hotchk155/pck100clone/docs/chklist.txt

CASE KIT, FASCIA PCB, MAIN PCB

CONTROL PCB W/HEADERS

FIXINGS 

POTS x 6, SWITCHES x 4

SOCKETS x 6

KNOBS x 6

RESISTORS x 13 VALUES 

CAPS/SEMIS

PIEZO

WIRE

LEAFLET

LABEL
