hotchk155/pck100clone/docs/resistorkit.odt

PCLONE2 Resistor Kit

330R x 1 ……….. ORANGE-ORANGE-BROWN

470R x 1…………YELLOW-VIOLET-BROWN

1k x 4 ……………BROWN-BLACK-RED

4k7 x 4 ………….YELLOW-VIOLET-RED

10k x 2 ………….BROWN-BLACK-ORANGE

22k x 5 ………….RED-RED-ORANGE

33k x 2 ………….ORANGE-ORANGE-ORANGE

47k x 12 …………YELLOW-VIOLET-ORANGE

56k x 1…………...GREEN-BLUE-ORANGE

100k x 10………..BROWN-BLACK-YELLOW

220k x 1 …………RED-RED-YELLOW

1M x 1……………BROWN-BLACK-GREEN

4M7 x 1 ………….YELLOW-VIOLET-GREEN

http://six4pix.com/pclone2

sixtyfourpixels@gmail.com

PCLONE2 Resistor Kit

330R x 1 ……….. ORANGE-ORANGE-BROWN

470R x 1…………YELLOW-VIOLET-BROWN

1k x 4 ……………BROWN-BLACK-RED

4k7 x 4 ………….YELLOW-VIOLET-RED

10k x 2 ………….BROWN-BLACK-ORANGE

22k x 5 ………….RED-RED-ORANGE

33k x 2 ………….ORANGE-ORANGE-ORANGE

47k x 12 …………YELLOW-VIOLET-ORANGE

56k x 1…………...GREEN-BLUE-ORANGE

100k x 10………..BROWN-BLACK-YELLOW

220k x 1 …………RED-RED-YELLOW

1M x 1……………BROWN-BLACK-GREEN

4M7 x 1 ………….YELLOW-VIOLET-GREEN

http://six4pix.com/pclone2

sixtyfourpixels@gmail.com

PCLONE2 Resistor Kit

330R x 1 ……….. ORANGE-ORANGE-BROWN

470R x 1…………YELLOW-VIOLET-BROWN

1k x 4 ……………BROWN-BLACK-RED

4k7 x 4 ………….YELLOW-VIOLET-RED

10k x 2 ………….BROWN-BLACK-ORANGE

22k x 5 ………….RED-RED-ORANGE

33k x 2 ………….ORANGE-ORANGE-ORANGE

47k x 12 …………YELLOW-VIOLET-ORANGE

56k x 1…………...GREEN-BLUE-ORANGE

100k x 10………..BROWN-BLACK-YELLOW

220k x 1 …………RED-RED-YELLOW

1M x 1……………BROWN-BLACK-GREEN

4M7 x 1 ………….YELLOW-VIOLET-GREEN

http://six4pix.com/pclone2

sixtyfourpixels@gmail.com

PCLONE2 Resistor Kit

330R x 1 ……….. ORANGE-ORANGE-BROWN

470R x 1…………YELLOW-VIOLET-BROWN

1k x 4 ……………BROWN-BLACK-RED

4k7 x 4 ………….YELLOW-VIOLET-RED

10k x 2 ………….BROWN-BLACK-ORANGE

22k x 5 ………….RED-RED-ORANGE

33k x 2 ………….ORANGE-ORANGE-ORANGE

47k x 12 …………YELLOW-VIOLET-ORANGE

56k x 1…………...GREEN-BLUE-ORANGE

100k x 10………..BROWN-BLACK-YELLOW

220k x 1 …………RED-RED-YELLOW

1M x 1……………BROWN-BLACK-GREEN

4M7 x 1 ………….YELLOW-VIOLET-GREEN

http://six4pix.com/pclone2

sixtyfourpixels@gmail.com

PCLONE2 Resistor Kit

330R x 1 ……….. ORANGE-ORANGE-BROWN

470R x 1…………YELLOW-VIOLET-BROWN

1k x 4 ……………BROWN-BLACK-RED

4k7 x 4 ………….YELLOW-VIOLET-RED

10k x 2 ………….BROWN-BLACK-ORANGE

22k x 5 ………….RED-RED-ORANGE

33k x 2 ………….ORANGE-ORANGE-ORANGE

47k x 12 …………YELLOW-VIOLET-ORANGE

56k x 1…………...GREEN-BLUE-ORANGE

100k x 10………..BROWN-BLACK-YELLOW

220k x 1 …………RED-RED-YELLOW

1M x 1……………BROWN-BLACK-GREEN

4M7 x 1 ………….YELLOW-VIOLET-GREEN

http://six4pix.com/pclone2

sixtyfourpixels@gmail.com

PCLONE2 Resistor Kit

330R x 1 ……….. ORANGE-ORANGE-BROWN

470R x 1…………YELLOW-VIOLET-BROWN

1k x 4 ……………BROWN-BLACK-RED

4k7 x 4 ………….YELLOW-VIOLET-RED

10k x 2 ………….BROWN-BLACK-ORANGE

22k x 5 ………….RED-RED-ORANGE

33k x 2 ………….ORANGE-ORANGE-ORANGE

47k x 12 …………YELLOW-VIOLET-ORANGE

56k x 1…………...GREEN-BLUE-ORANGE

100k x 10………..BROWN-BLACK-YELLOW

220k x 1 …………RED-RED-YELLOW

1M x 1……………BROWN-BLACK-GREEN

4M7 x 1 ………….YELLOW-VIOLET-GREEN

http://six4pix.com/pclone2

sixtyfourpixels@gmail.com

PCLONE2 Resistor Kit

330R x 1 ……….. ORANGE-ORANGE-BROWN

470R x 1…………YELLOW-VIOLET-BROWN

1k x 4 ……………BROWN-BLACK-RED

4k7 x 4 ………….YELLOW-VIOLET-RED

10k x 2 ………….BROWN-BLACK-ORANGE

22k x 5 ………….RED-RED-ORANGE

33k x 2 ………….ORANGE-ORANGE-ORANGE

47k x 12 …………YELLOW-VIOLET-ORANGE

56k x 1…………...GREEN-BLUE-ORANGE

100k x 10………..BROWN-BLACK-YELLOW

220k x 1 …………RED-RED-YELLOW

1M x 1……………BROWN-BLACK-GREEN

4M7 x 1 ………….YELLOW-VIOLET-GREEN

http://six4pix.com/pclone2

sixtyfourpixels@gmail.com

PCLONE2 Resistor Kit

330R x 1 ……….. ORANGE-ORANGE-BROWN

470R x 1…………YELLOW-VIOLET-BROWN

1k x 4 ……………BROWN-BLACK-RED

4k7 x 4 ………….YELLOW-VIOLET-RED

10k x 2 ………….BROWN-BLACK-ORANGE

22k x 5 ………….RED-RED-ORANGE

33k x 2 ………….ORANGE-ORANGE-ORANGE

47k x 12 …………YELLOW-VIOLET-ORANGE

56k x 1…………...GREEN-BLUE-ORANGE

100k x 10………..BROWN-BLACK-YELLOW

220k x 1 …………RED-RED-YELLOW

1M x 1……………BROWN-BLACK-GREEN

4M7 x 1 ………….YELLOW-VIOLET-GREEN

http://six4pix.com/pclone2

sixtyfourpixels@gmail.com
