hotchk155/pck100clone/hardware_smt/schem.png

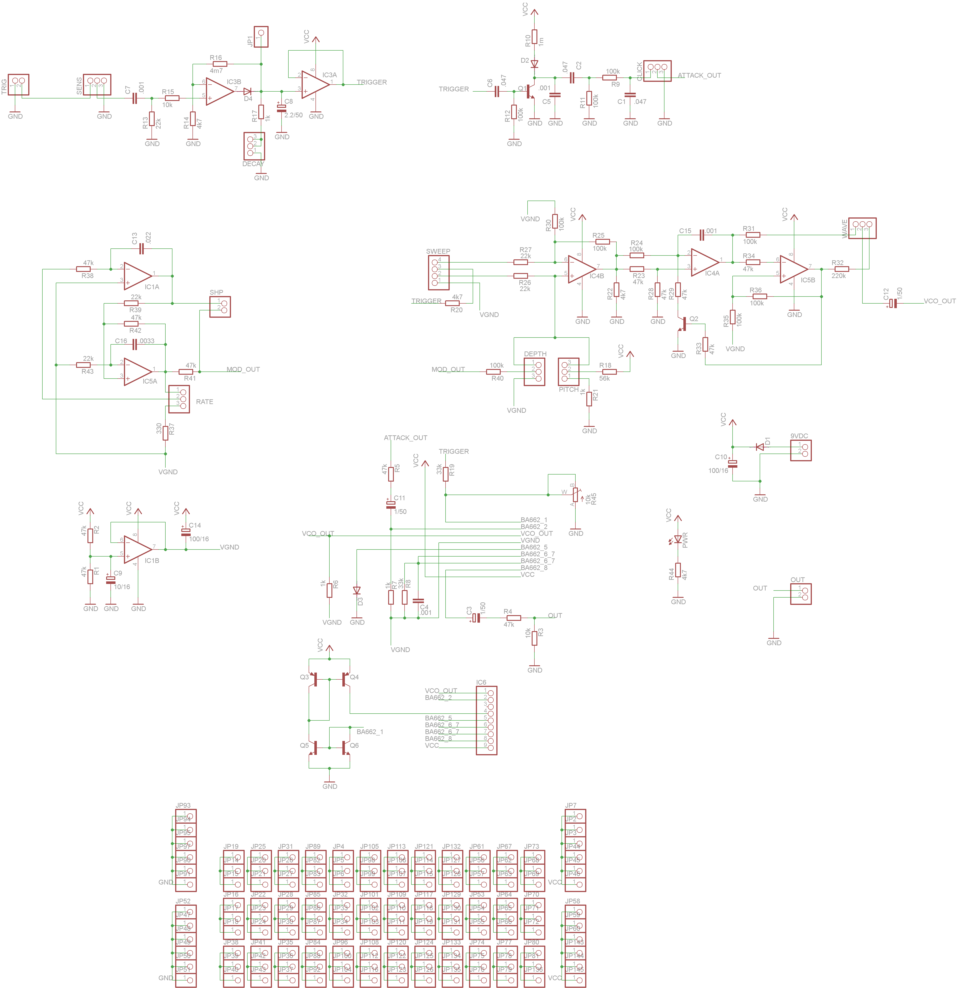
hardware_smt/schem.png
