hotchk155/pck100clone/panel/pclone2_panel.brd

## EAGLE design panel/pclone2_panel.brd (2020-05-12)

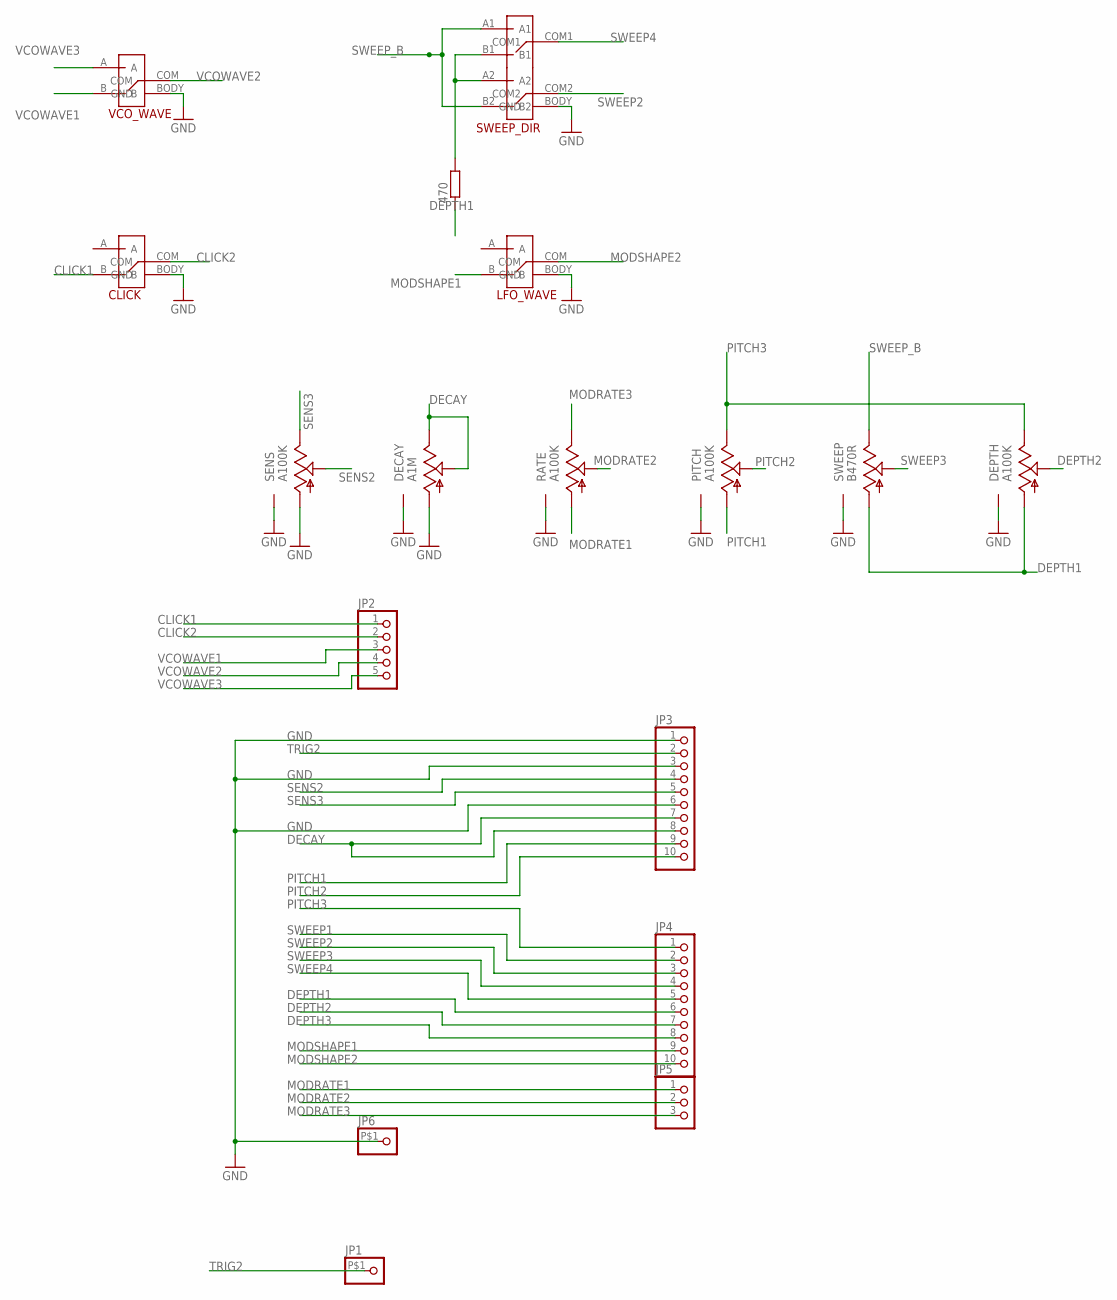
[picture p13: schematic pclone2_panel.sch]

Parts:
470: R-EU_R0805; R0805
CLICK: SPD_SMTD; SPDT_SMTD
DECAY: A1M; 16MM_POT_SMTD
DEPTH: A100K; 16MM_POT_SMTD
JP1, JP6: PINHD-1X1SMT; PINHEADPAD
JP2: HEADER-1X5SMT; 1X05_SMT
JP3, JP4: HEADER-1X10SMT; 1X10_SMT
JP5: HEADER-1X3SMT; 1X03_SMT
LFO_WAVE: SPD_SMTD; SPDT_SMTD
PITCH: A100K; 16MM_POT_SMTD
RATE: A100K; 16MM_POT_SMTD
SENS: A100K; 16MM_POT_SMTD
SWEEP: B470R; 16MM_POT_SMTD
SWEEP_DIR: DPDT_SMTD
VCO_WAVE: SPD_SMTD; SPDT_SMTD

Connections:
CLICK1: CLICK.B, JP2.1
CLICK2: CLICK.COM, JP2.2
DECAY: DECAY.B, DECAY.W, JP3.7, JP3.8
DEPTH1: 470.1, DEPTH.A, JP4.6, SWEEP.A
DEPTH2: DEPTH.W, JP4.7
DEPTH3: JP4.8
GND: CLICK.BODY (GND), DECAY.A, DECAY.BODY (GND), DEPTH.BODY (GND), JP3.1, JP3.3, JP3.6, JP6.P$1, LFO_WAVE.BODY (GND), PITCH.BODY (GND), RATE.BODY (GND), SENS.A, SENS.BODY (GND), SWEEP.BODY (GND), SWEEP_DIR.BODY (GND), VCO_WAVE.BODY (GND)
MODRATE1: JP5.1, RATE.A
MODRATE2: JP5.2, RATE.W
MODRATE3: JP5.3, RATE.B
MODSHAPE1: JP4.9, LFO_WAVE.B
MODSHAPE2: JP4.10, LFO_WAVE.COM
unnamed: 470.2, SWEEP_DIR.A2, SWEEP_DIR.B1
PITCH1: JP3.9, PITCH.A
PITCH2: JP3.10, PITCH.W
PITCH3: DEPTH.B, JP4.1, PITCH.B
SENS2: JP3.4, SENS.W
SENS3: JP3.5, SENS.B
SWEEP1: JP4.2
SWEEP2: JP4.3, SWEEP_DIR.COM2
SWEEP3: JP4.4, SWEEP.W
SWEEP4: JP4.5, SWEEP_DIR.COM1
SWEEP_B: SWEEP.B, SWEEP_DIR.A1, SWEEP_DIR.B2
TRIG2: JP1.P$1, JP3.2
VCOWAVE1: JP2.3, VCO_WAVE.B
VCOWAVE2: JP2.4, VCO_WAVE.COM
VCOWAVE3: JP2.5, VCO_WAVE.A

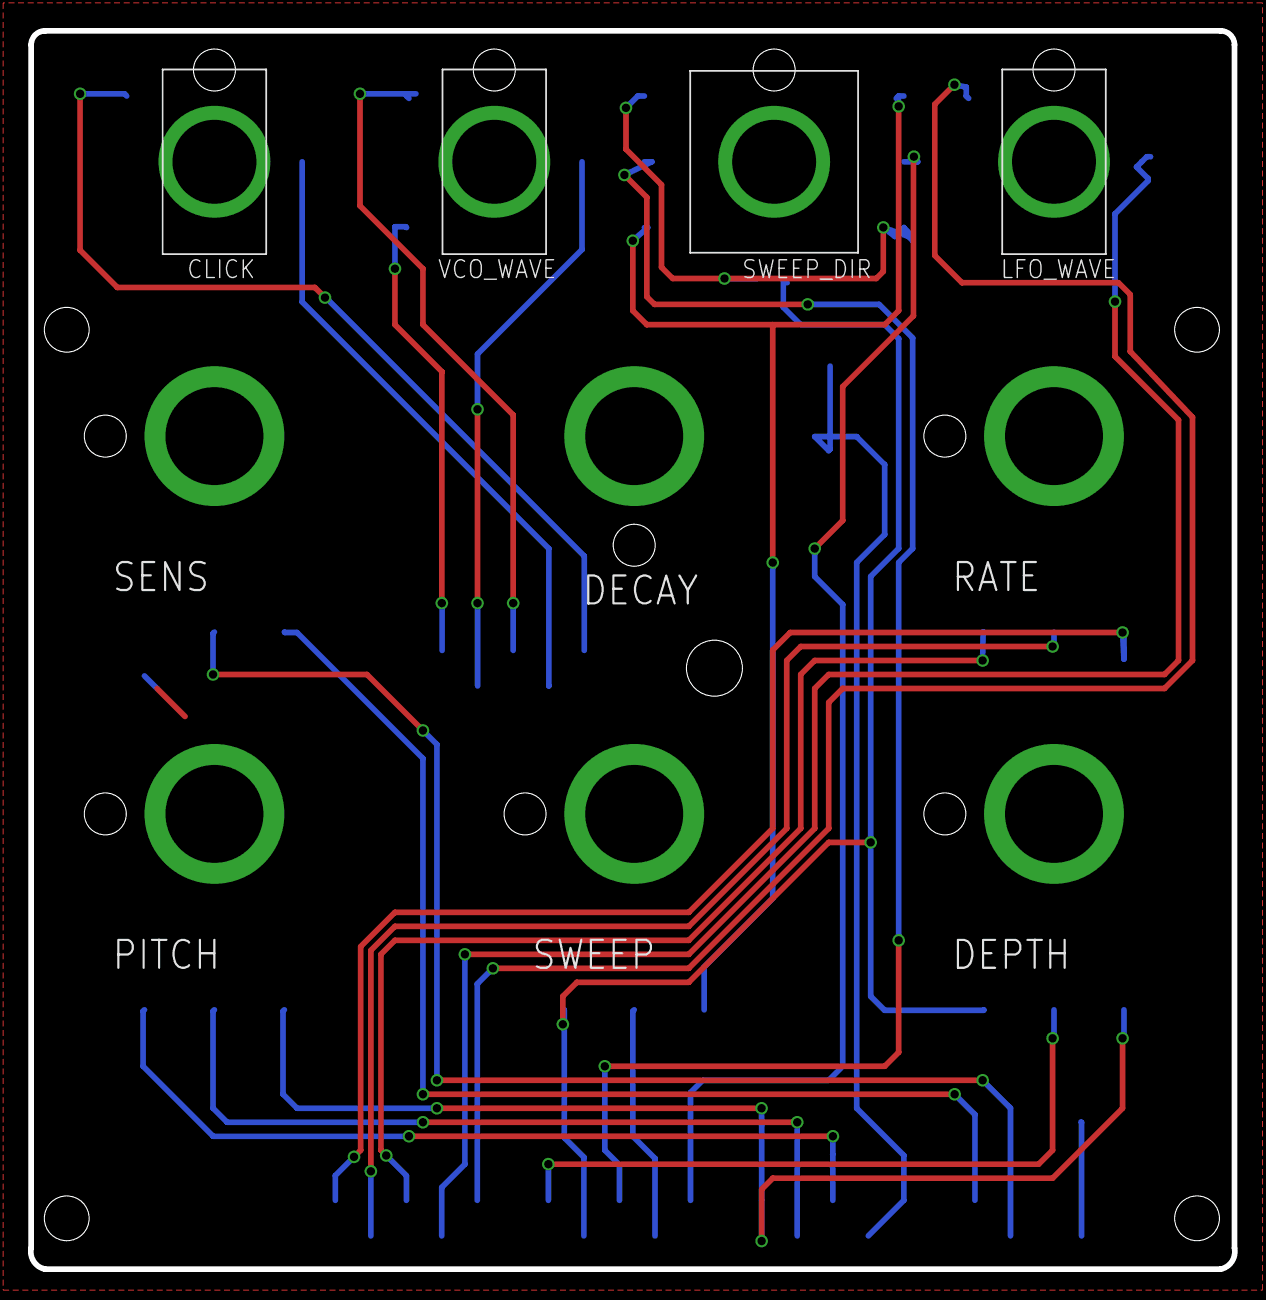
[picture p14: board pclone2_panel.brd from above]

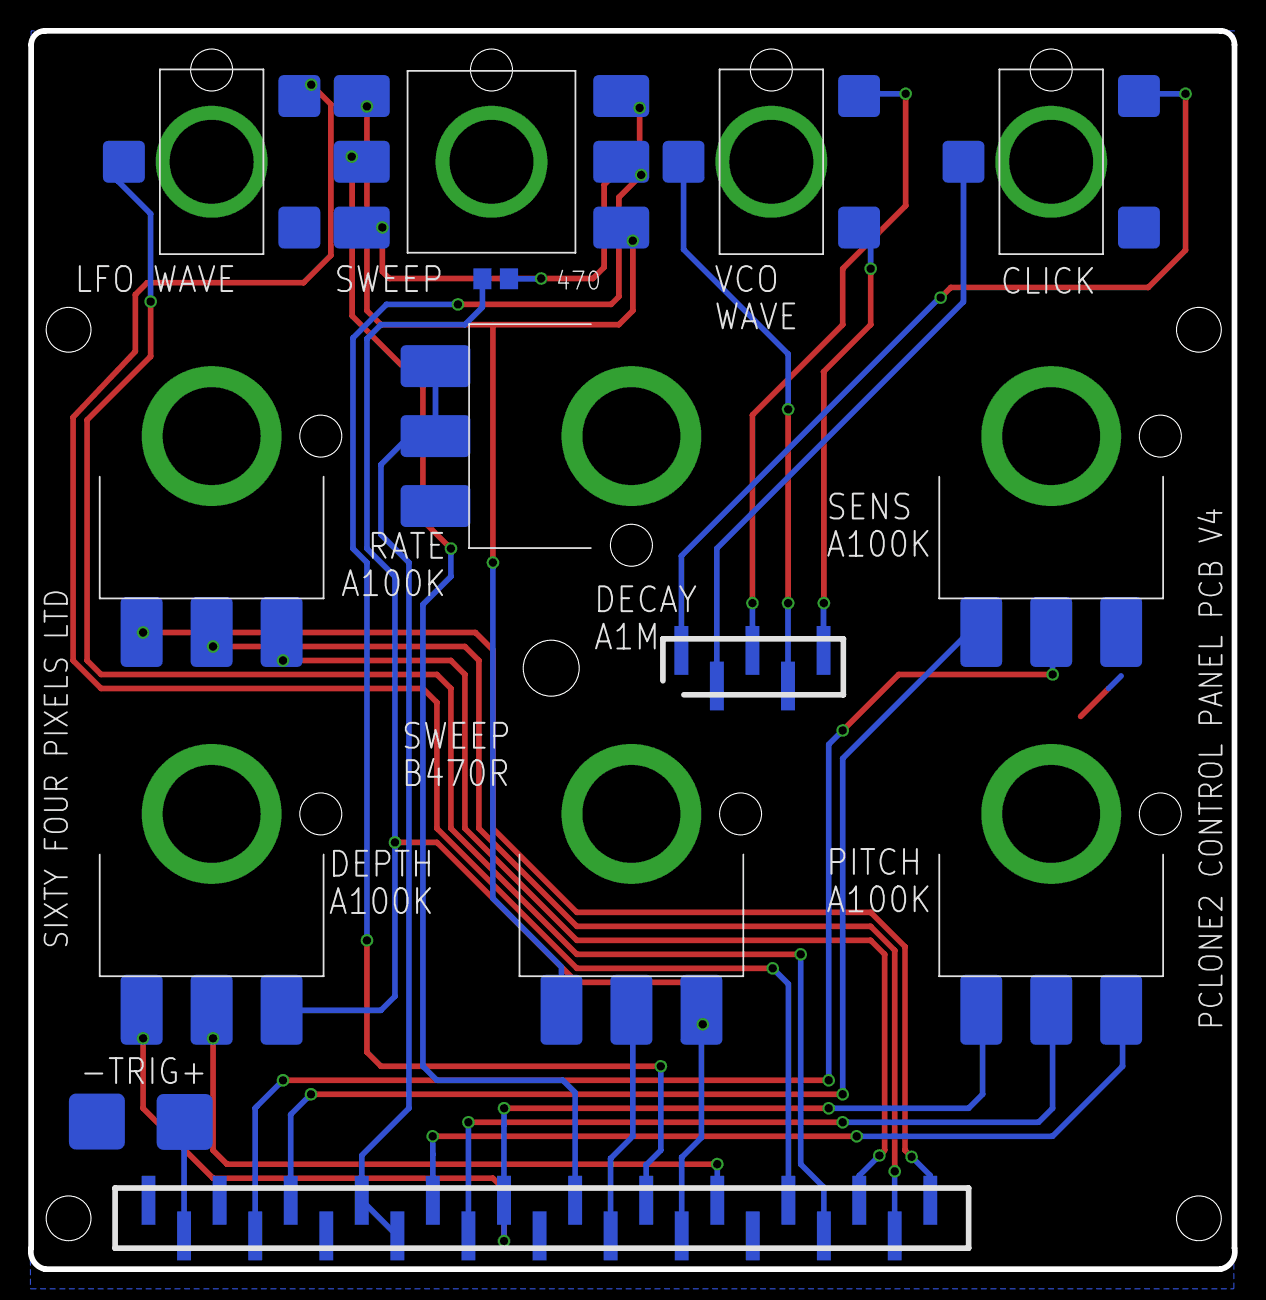
[picture p15: board pclone2_panel.brd from below]

Board: 2 copper layers, 86.0 x 88.5 mm, 17 parts (7 on the bottom side), 25 nets.
