hotchk155/pck100clone/hardware/pck100clone.brd

## EAGLE design hardware/pck100clone.brd (2016-07-11)

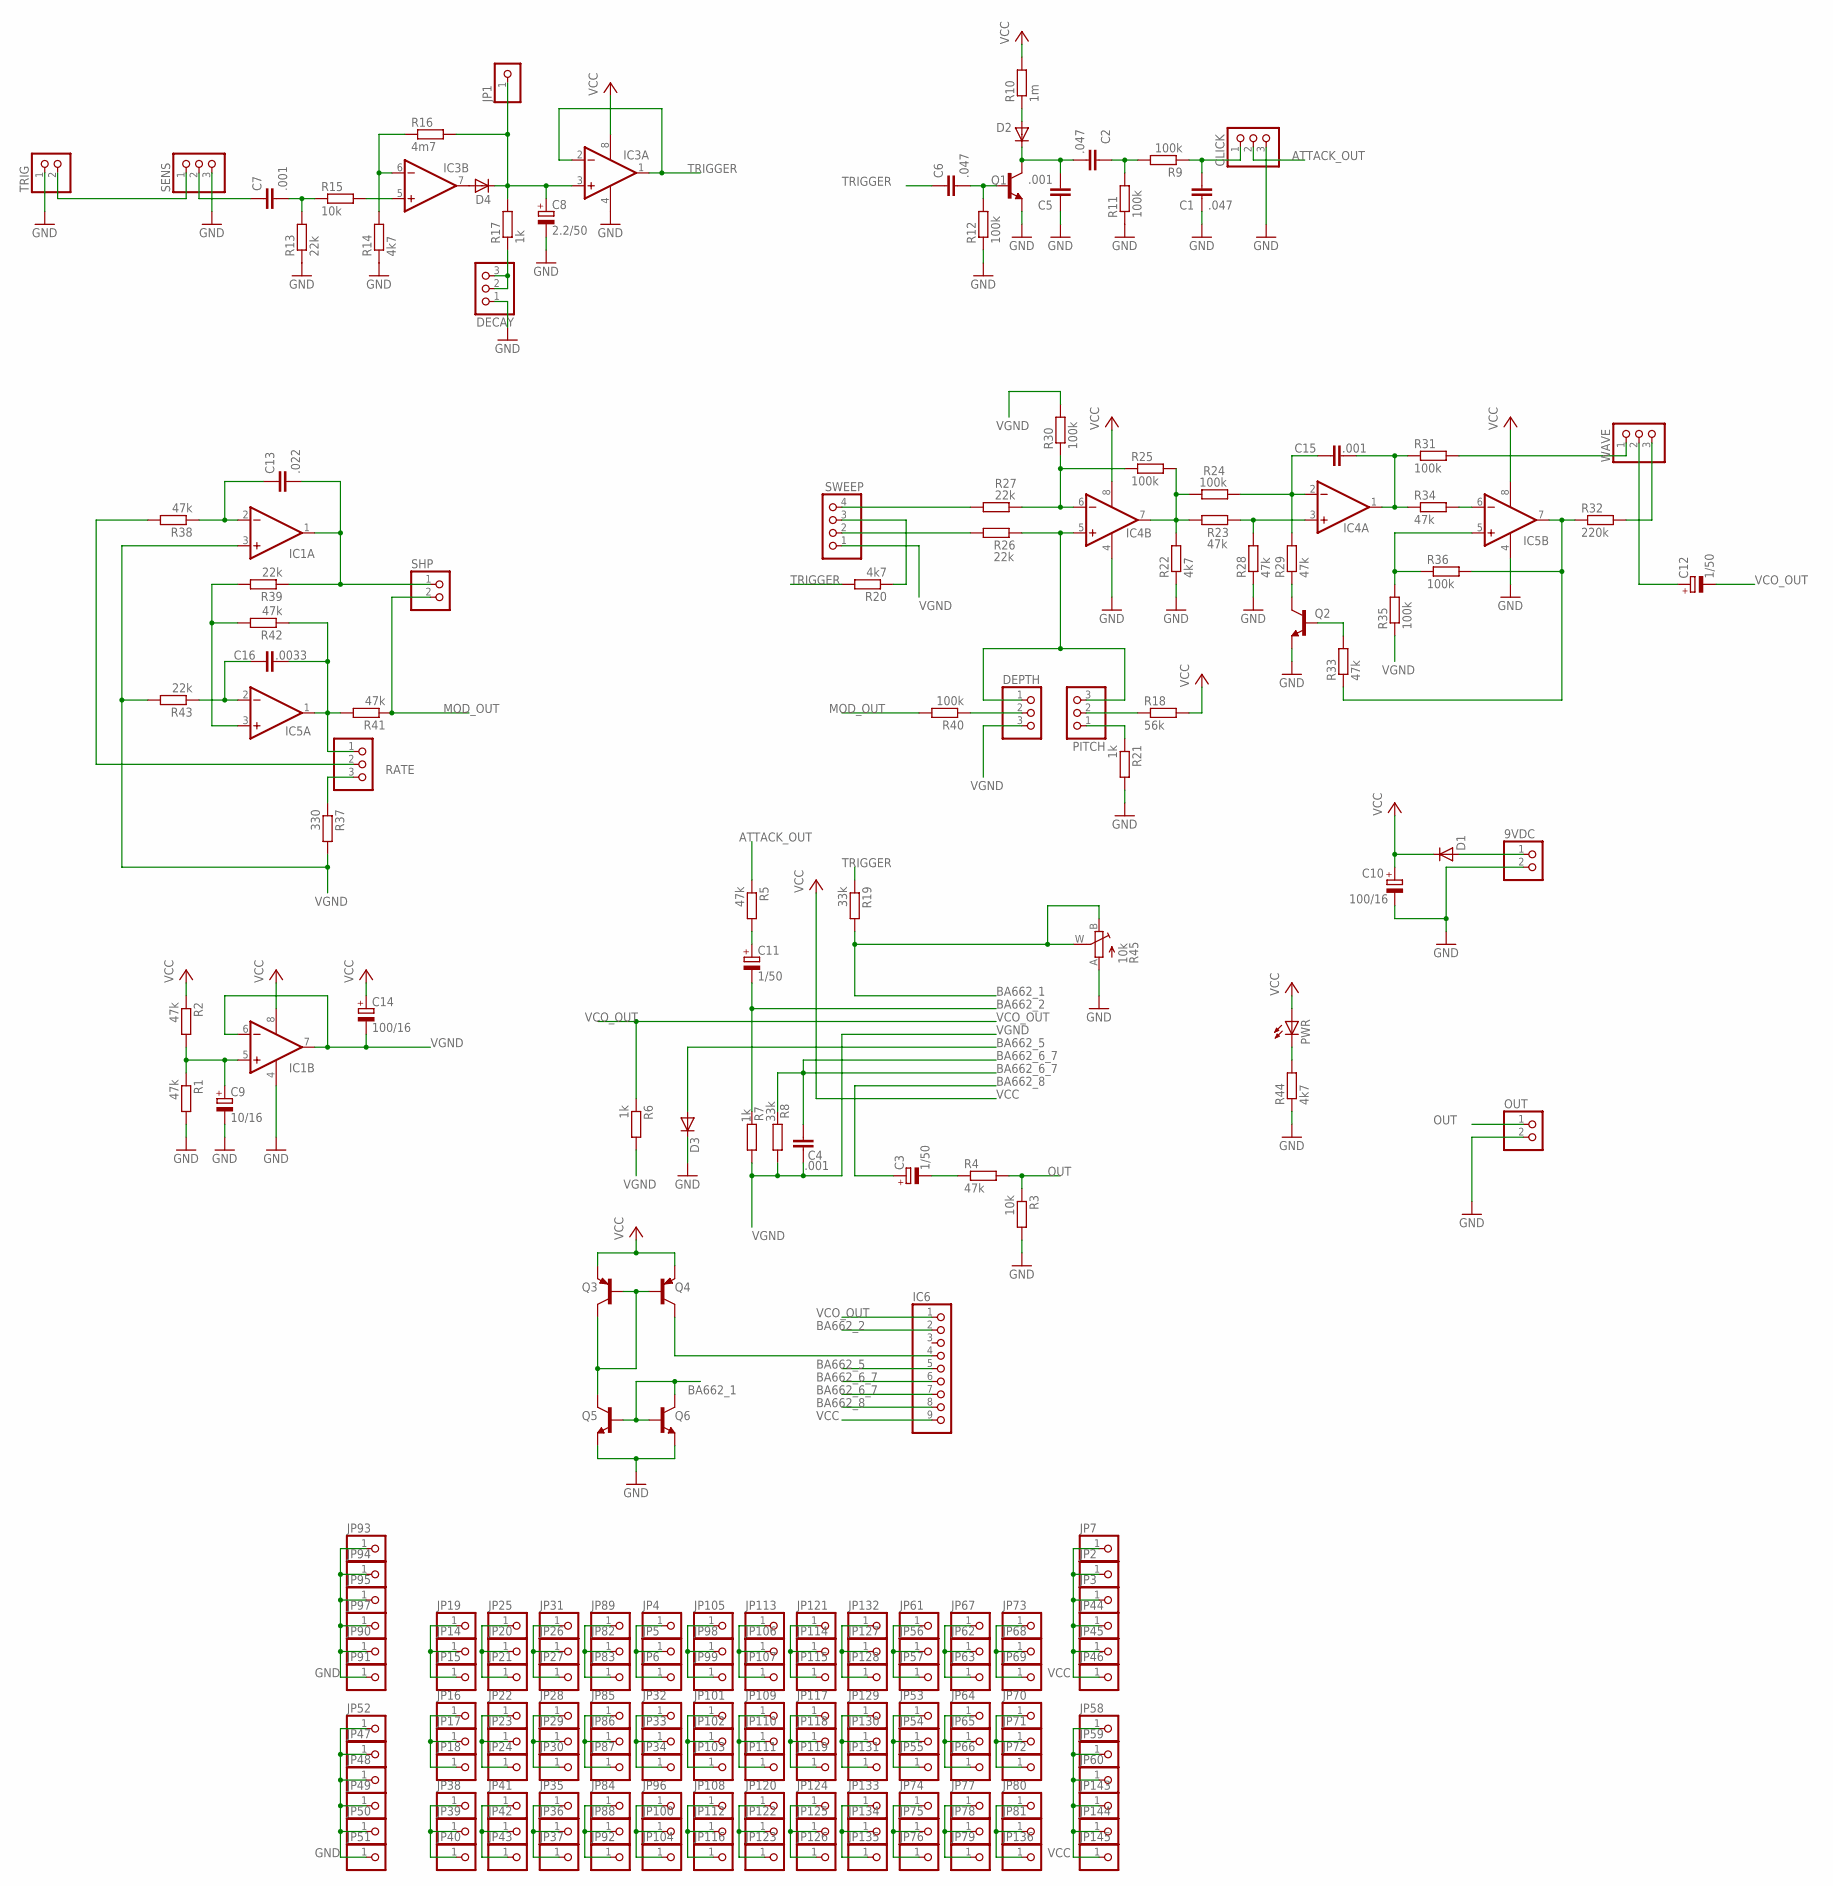
[picture p16: schematic pck100clone.sch]

Parts:
9VDC: PINHD-1X2; 1X02
C1, C2, C6: .047; C050-025X075
C3, C11, C12: 1/50; E2,5-5
C4, C5, C7, C15: .001; C050-025X075
C8: 2.2/50; E2,5-5
C9: 10/16; E2,5-5
C10, C14: 100/16; E2,5-5
C13: .022; C050-025X075
C16: .0033; C050-025X075
CLICK: PINHD-1X3; 1X03
D1: 1N4004; DO41-10
D2, D3, D4: 1N4148DO35-7; DO35-7
DECAY: PINHD-1X3; 1X03
DEPTH: PINHD-1X3; 1X03
IC1, IC3, IC4, IC5: LM358N; DIL08
IC6: PINHD-1X9; 1X09
JP1, JP2, JP3, JP4, JP5, JP6, JP7, JP14, JP15, JP16, JP17, JP18, JP19, JP20, JP21, JP22, JP23, JP24, JP25, JP26, JP27, JP28, JP29, JP30, JP31, JP32, JP33, JP34, JP35, JP36, JP37, JP38, JP39, JP40, JP41, JP42, JP43, JP44, JP45, JP46, JP47, JP48, JP49, JP50, JP51, JP52, JP53, JP54, JP55, JP56, JP57, JP58, JP59, JP60, JP61, JP62, JP63, JP64, JP65, JP66, JP67, JP68, JP69, JP70, JP71, JP72, JP73, JP74, JP75, JP76, JP77, JP78, JP79, JP80, JP81, JP82, JP83, JP84, JP85, JP86, JP87, JP88, JP89, JP90, JP91, JP92, JP93, JP94, JP95, JP96, JP97, JP98, JP99, JP100, JP101, JP102, JP103, JP104, JP105, JP106, JP107, JP108, JP109, JP110, JP111, JP112, JP113, JP114, JP115, JP116, JP117, JP118, JP119, JP120, JP121, JP122, JP123, JP124, JP125, JP126, JP127, JP128, JP129, JP130, JP131, JP132, JP133, JP134, JP135, JP136, JP143, JP144, JP145: PINHD-1X1; 1X01
OUT: PINHD-1X2; 1X02
PITCH: PINHD-1X3; 1X03
PWR: LED3MM
Q1, Q2: 2SC945; TO92-ECB
Q3, Q4: 2N3906; TO92
Q5, Q6: 2N3904; TO92
R1, R2, R4, R5, R23, R28, R29, R33, R34, R38, R41, R42: 47k; 0207/7
R3, R15: 10k; 0207/7
R6, R7, R17, R21: 1k; 0207/7
R8, R19: 33k; 0207/7
R9, R11, R12, R24, R25, R30, R31, R35, R36, R40: 100k; 0207/7
R10: 1m; 0207/7
R13, R26, R27, R39, R43: 22k; 0207/7
R14, R20, R22, R44: 4k7; 0207/7
R16: 4m7; 0207/7
R18: 56k; 0207/7
R32: 220k; 0207/7
R37: 330; 0207/7
R45: 10k; TRIM-N
RATE: PINHD-1X3; 1X03
SENS: PINHD-1X3; 1X03
SHP: PINHD-1X2; 1X02
SWEEP: PINHD-1X4; 1X04
TRIG: PINHD-1X2; 1X02
WAVE: PINHD-1X3; 1X03

Connections:
ATTACK_OUT: CLICK.2, R5.1
BA662_1: Q5.2 (B), Q6.1 (C), Q6.2 (B), R19.2, R45.B (E), R45.W (S)
BA662_2: C11.-, IC6.2, R7.1
BA662_5: D3.A, IC6.5
BA662_6_7: C4.2, IC6.6, IC6.7, R8.1
BA662_8: C3.+, IC6.8
GND: 9VDC.2, C1.1, C5.1, C8.-, C9.-, C10.-, CLICK.3, D3.C, DECAY.1, IC1.4 (V-), IC3.4 (V-), IC4.4 (V-), IC5.4 (V-), JP47.1, JP48.1, JP49.1, JP50.1, JP51.1, JP52.1, JP90.1, JP91.1, JP93.1, JP94.1, JP95.1, JP97.1, OUT.2, Q1.E, Q2.E, Q5.3 (E), Q6.3 (E), R1.2, R3.2, R11.1, R12.1, R13.1, R14.1, R21.2, R22.1, R28.1, R44.1, R45.A, SENS.3, TRIG.1
MOD_OUT: R40.2, R41.1, SHP.2
unnamed: SENS.1, TRIG.2
unnamed: 9VDC.1, D1.A
unnamed: C7.1, SENS.2
unnamed: C7.2, R13.2, R15.1
unnamed: IC3.5 (+IN), R15.2
unnamed: IC3.6 (-IN), R14.2, R16.1
unnamed: D4.A, IC3.7 (OUT)
unnamed: C8.+, D4.C, IC3.3 (+IN), JP1.1, R16.2, R17.2
unnamed: DECAY.2, DECAY.3, R17.1
unnamed: C6.2, Q1.B, R12.2
unnamed: C2.2, C5.2, D2.C, Q1.C
unnamed: D2.A, R10.1
unnamed: C2.1, R9.2, R11.2
unnamed: C1.2, CLICK.1, R9.1
unnamed: C13.2, IC1.1 (OUT), R39.1, SHP.1
unnamed: C13.1, IC1.2 (-IN), R38.1
unnamed: R38.2, RATE.2
unnamed: JP4.1, JP5.1, JP6.1
unnamed: C16.1, IC5.2 (-IN), R43.1
unnamed: C16.2, IC5.1 (OUT), R41.2, R42.1, RATE.1
unnamed: R20.1, SWEEP.3
unnamed: R37.1, RATE.3
unnamed: IC5.3 (+IN), R39.2, R42.2
unnamed: R27.2, SWEEP.4
unnamed: R26.2, SWEEP.2
unnamed: IC4.6 (-IN), R25.1, R27.1, R30.1
unnamed: DEPTH.1, IC4.5 (+IN), PITCH.3, R26.1
unnamed: DEPTH.2, R40.1
unnamed: PITCH.2, R18.1
unnamed: PITCH.1, R21.1
unnamed: C9.+, IC1.5 (+IN), R1.1, R2.2
unnamed: IC4.7 (OUT), R22.2, R23.1, R24.1, R25.2
unnamed: IC4.3 (+IN), R23.2, R28.2
unnamed: C15.2, IC4.2 (-IN), R24.2, R29.2
unnamed: Q2.C, R29.1
unnamed: Q2.B, R33.2
unnamed: C15.1, IC4.1 (OUT), R31.1, R34.1
unnamed: IC5.6 (-IN), R34.2
unnamed: R31.2, WAVE.1
unnamed: IC5.7 (OUT), R32.1, R33.1, R36.2
unnamed: R32.2, WAVE.3
unnamed: IC5.5 (+IN), R35.2, R36.1
unnamed: C12.+, WAVE.2
unnamed: PWR.K (C), R44.2
unnamed: IC6.4, Q4.1 (C)
unnamed: C11.+, R5.2
unnamed: Q3.1 (C), Q3.2 (B), Q4.2 (B), Q5.1 (C)
unnamed: JP14.1, JP15.1, JP19.1
unnamed: C3.-, R4.1
unnamed: JP16.1, JP17.1, JP18.1
unnamed: JP20.1, JP21.1, JP25.1
unnamed: JP22.1, JP23.1, JP24.1
unnamed: JP26.1, JP27.1, JP31.1
unnamed: JP28.1, JP29.1, JP30.1
unnamed: JP32.1, JP33.1, JP34.1
unnamed: JP35.1, JP36.1, JP37.1
unnamed: JP38.1, JP39.1, JP40.1
unnamed: JP41.1, JP42.1, JP43.1
unnamed: JP53.1, JP54.1, JP55.1
unnamed: JP56.1, JP57.1, JP61.1
unnamed: JP62.1, JP63.1, JP67.1
unnamed: JP64.1, JP65.1, JP66.1
unnamed: JP68.1, JP69.1, JP73.1
unnamed: JP70.1, JP71.1, JP72.1
unnamed: JP74.1, JP75.1, JP76.1
unnamed: JP77.1, JP78.1, JP79.1
unnamed: JP80.1, JP81.1, JP136.1
unnamed: JP98.1, JP99.1, JP105.1
unnamed: JP82.1, JP83.1, JP89.1
unnamed: JP85.1, JP86.1, JP87.1
unnamed: JP101.1, JP102.1, JP103.1
unnamed: JP106.1, JP107.1, JP113.1
unnamed: JP109.1, JP110.1, JP111.1
unnamed: JP114.1, JP115.1, JP121.1
unnamed: JP117.1, JP118.1, JP119.1
unnamed: JP84.1, JP88.1, JP92.1
unnamed: JP96.1, JP100.1, JP104.1
unnamed: JP108.1, JP112.1, JP116.1
unnamed: JP120.1, JP122.1, JP123.1
unnamed: JP124.1, JP125.1, JP126.1
unnamed: JP127.1, JP128.1, JP132.1
unnamed: JP129.1, JP130.1, JP131.1
unnamed: JP133.1, JP134.1, JP135.1
OUT: OUT.1, R3.1, R4.2
TRIGGER: C6.1, IC3.1 (OUT), IC3.2 (-IN), R19.1, R20.2
VCC: C10.+, C14.+, D1.C, IC1.8 (V+), IC3.8 (V+), IC4.8 (V+), IC5.8 (V+), IC6.9, JP2.1, JP3.1, JP7.1, JP44.1, JP45.1, JP46.1, JP58.1, JP59.1, JP60.1, JP143.1, JP144.1, JP145.1, PWR.A, Q3.3 (E), Q4.3 (E), R2.1, R10.2, R18.2
VCO_OUT: C12.-, IC6.1, R6.1
VGND: C4.1, C14.-, DEPTH.3, IC1.3 (+IN), IC1.6 (-IN), IC1.7 (OUT), R6.2, R7.2, R8.2, R30.2, R35.1, R37.2, R43.2, SWEEP.1

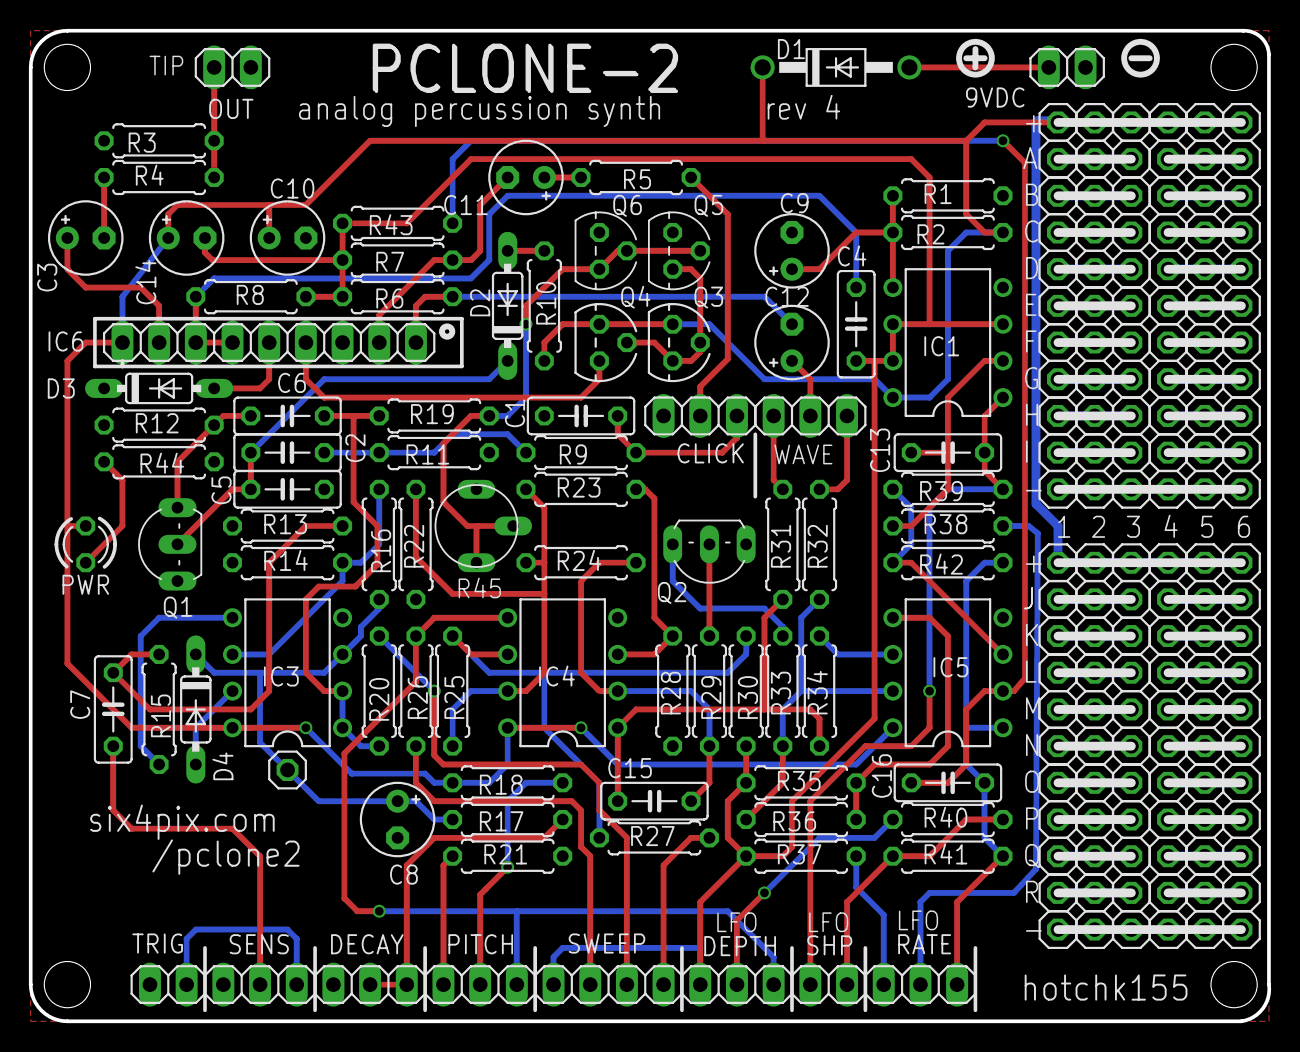
[picture p17: board pck100clone.brd from above]

Board: 2 copper layers, 85.7 x 68.6 mm, 222 parts (0 on the bottom side), 96 nets.
