hotchk155/pck100clone/(commit log)

2015-11-08 more changes
    [pck100clone.sch]
2015-11-08 almost done?
    [pck100clone.brd, pck100clone.sch]
2015-11-08 more fussing
    [pck100clone.brd, pck100clone.sch]
2015-11-26 pcb rev1
    [pck100clone.sch]
2015-12-26 added VCA pulldown
    [pck100clone.brd, pck100clone.sch]
2015-12-26 remove VCA pin 3 connection to VGND
    [pck100clone.brd, pck100clone.sch]
2015-12-26 moar stuff
    [pck100clone.brd, pck100clone.sch]
2015-12-26 cv patch point
    [pck100clone.brd, pck100clone.sch]
2015-12-26 control panel
    [pclone-control.brd, pclone-control.sch]
2016-01-05 work in progress
    [pck100clone.brd, pck100clone.sch, pclone-control.brd, pclone-control.sch]
2016-06-13 tidy up project
    [pck100clone.brd, pck100clone.sch, pclone-control.brd, pclone-control.sch]
2016-07-11 REV4
    add vca input trim / add series polarity diode
    [pck100clone.brd, pck100clone.sch]
2016-07-22 setup for cut
2018-11-24 control panel board
    [pclone-control.brd, pclone2_panel.brd, pclone2_panel.sch]
2018-11-24 PANEL CHANGES
    [pclone2_panel.brd, pclone2_panel.sch]
2018-11-26 FIRST PCB FAB V1
    [pclone2_panel.brd]
2018-12-21 v2 - smt headers
    [pclone2_panel.brd, pclone2_panel.sch]
2018-12-21 silk changes
    [pclone2_panel.brd]
2019-01-30 V3 reroute to avoid washers
    [pclone2_panel.brd, pclone2_panel.sch]
2019-01-30 text moved
    [pclone2_panel.brd]
2019-02-26 change for new front panel pcb
2019-02-28 power socket change
2019-11-20 add 4 colour band resistor codes
2020-05-12 V4 Panel
    Moved tracks away from hole. Added extra hole for piezo wires. Additional ground plane clearance
    [pclone2_panel.brd]
